bismarx-v1/IOTGW/IoTGW_Isolation/_dimensions/IoTGW_Isolation_3D.step

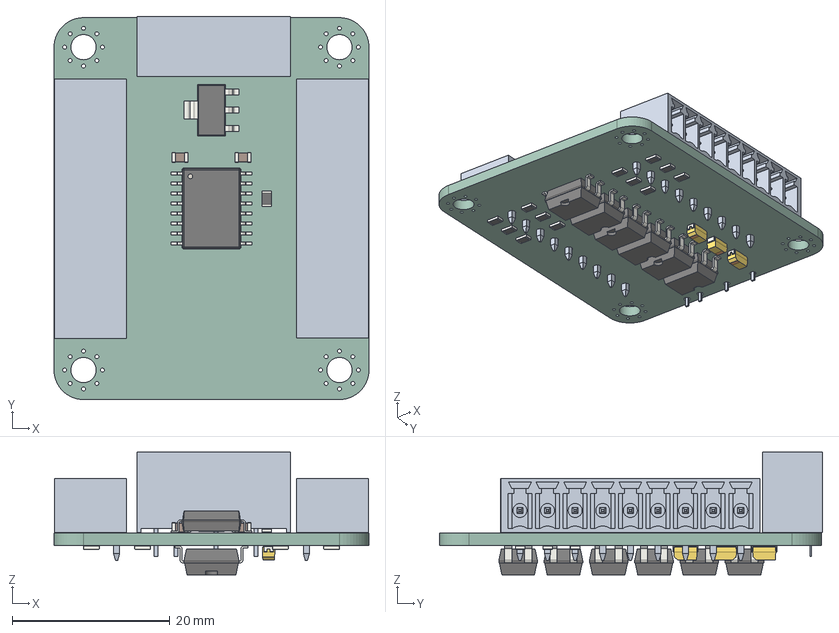
[picture p1: CAD file, 2025-01-31]
IoTGW_Isolation/_dimensions/IoTGW_Isolation_3D.step
40.0 x 48.7 x 15.6 mm
SOT_223
SOIC_16W_75x103mm_P127mm
R_0805_2012Metric x 13
C_0805_2012Metric x 2
TBA2-SINGLE
SMDIP_4_W953mm x 6
CP_EIA_3216_18_Kemet_A x 3
_autosave-IoTGW_Isolation_PCB
