bismarx-v1/IOTGW/IoTGW_Isolation/_dimensions/IoTGW_Isolation_schematic.pdf

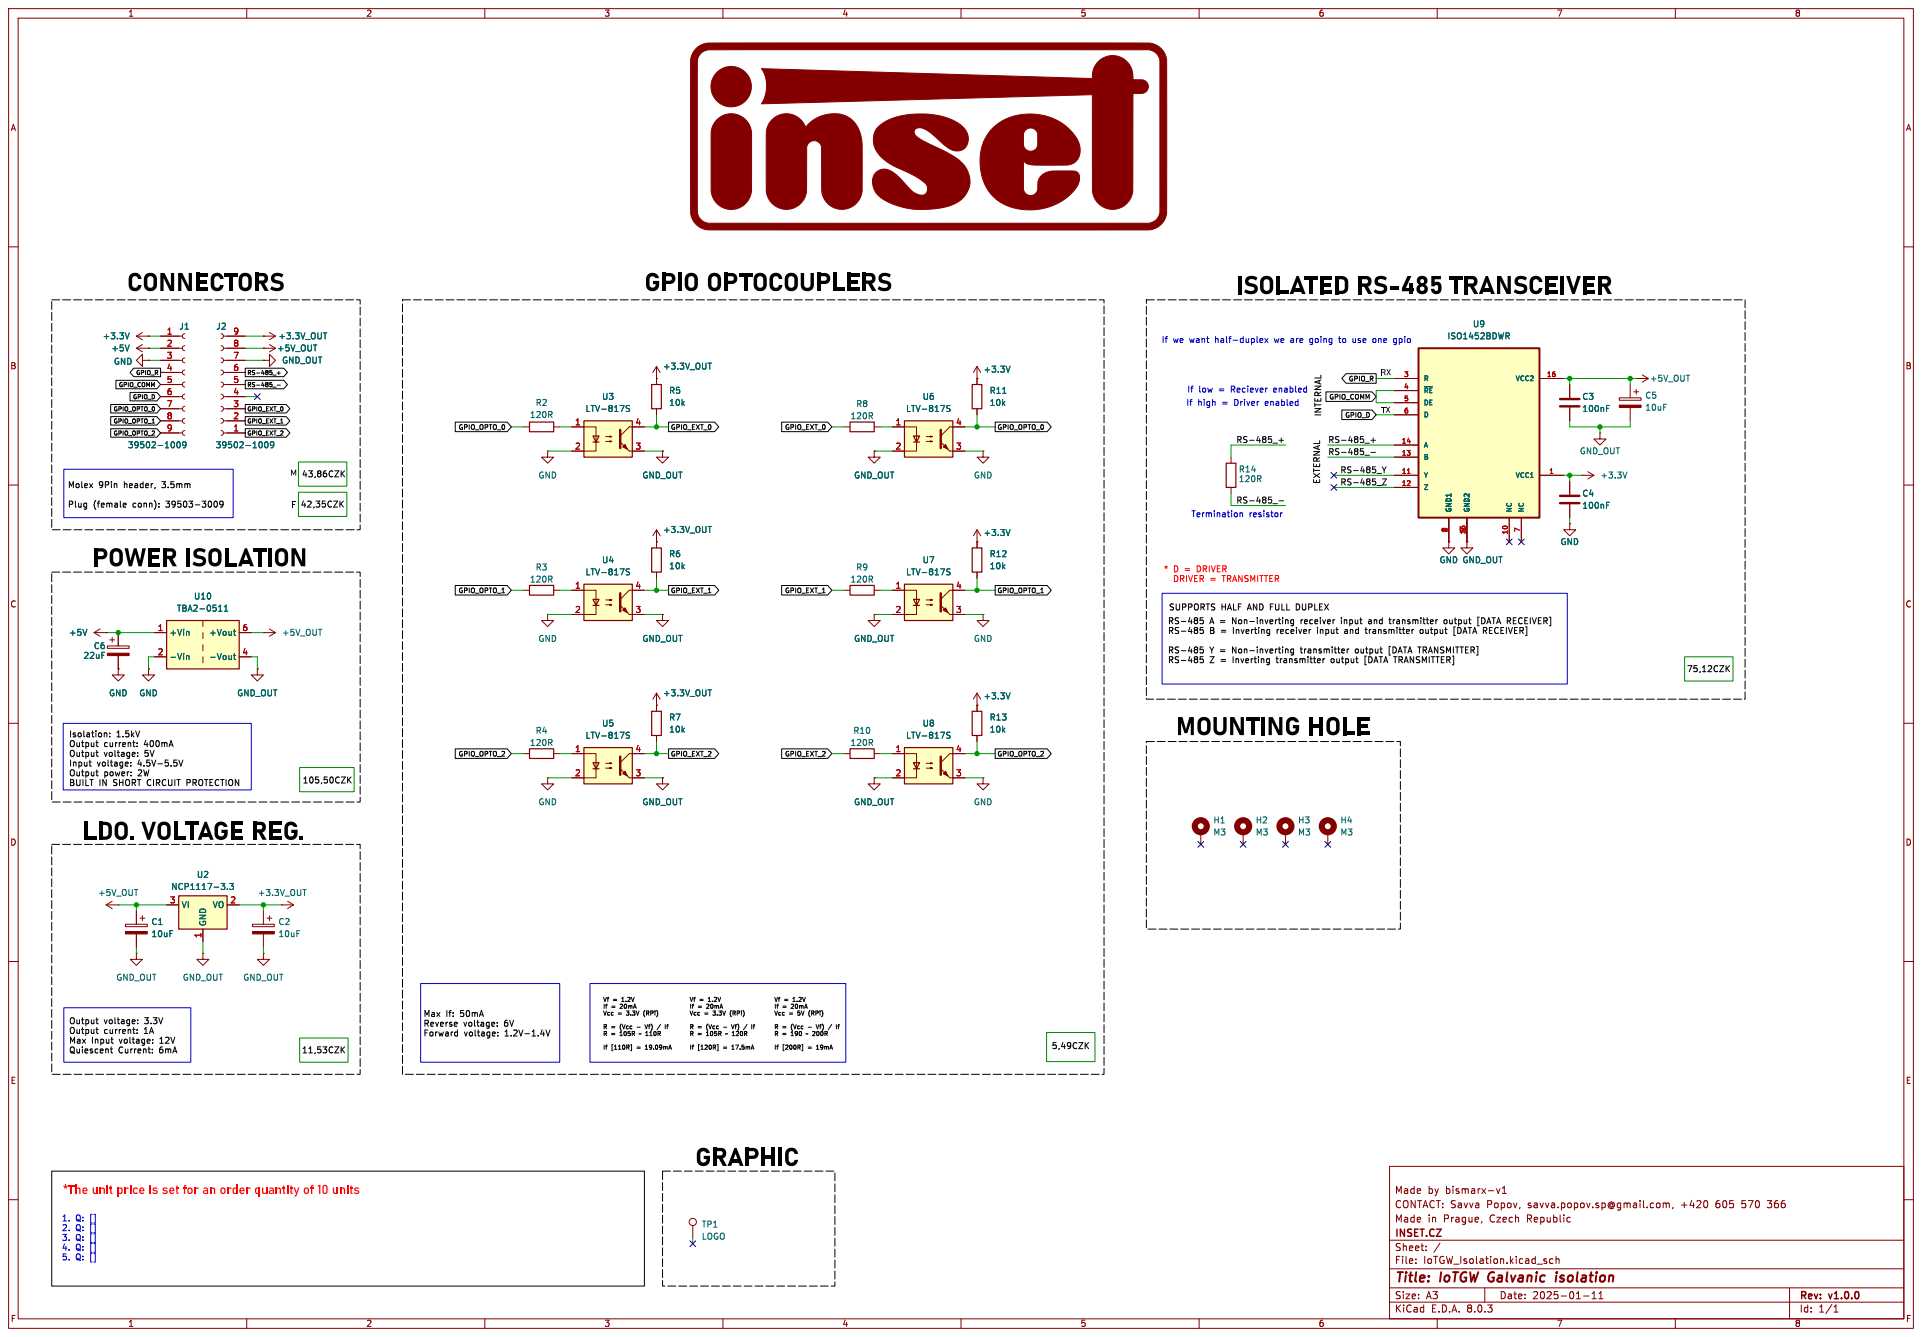
[picture p2: page 1]

Input voltage: 4.5V-5.5V Output power: 2W

Vcc = 3.3V (RPi) R = (Vcc - Vf) / If R = 105R ~ 110R

Vcc = 3.3V (RPi) R = (Vcc - Vf) / If R = 105R ~ 120R

Vcc = 5V (RPi) R = (Vcc - Vf) / If R = 190 ~ 200R

Max If: 50mA Reverse voltage: 6V

*The unit price is set for an order quantity of 10units

Id: 1/1 Title: IoTGW Galvanic isolation
