bismarx-v1/IOTGW/IoTGW_Isolation/_dimensions/IoTGW_Isolation_PCB_dimensions.pdf

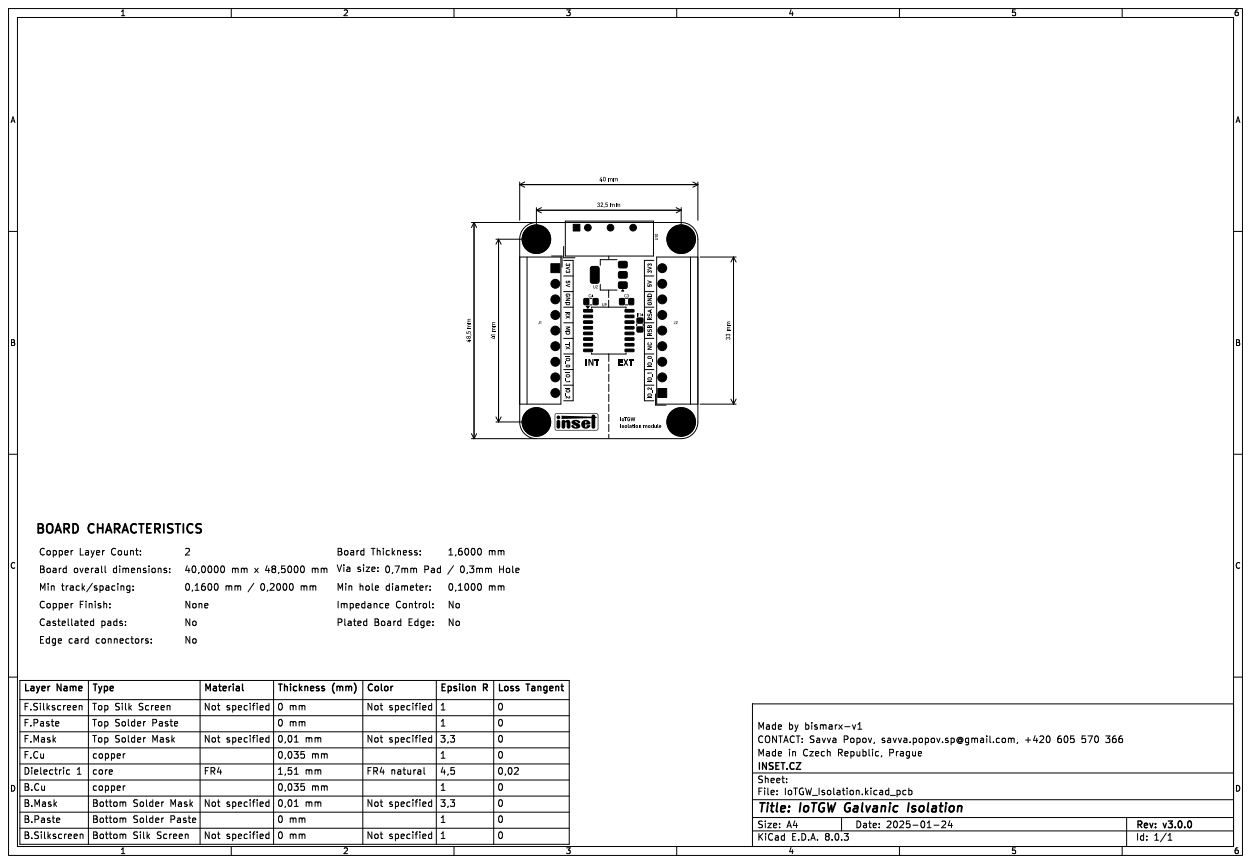
[picture p3: page 1]

Plated Board Edge:
Not specified Not specified FR4 natural Not specified

File: IoTGW_Isolation.kicad_pcb Sheet:
Id: 1/1 Title: IoTGW Galvanic Isolation
