bismarx-v1/IOTGW/IoTGW_Isolation/IoTGW_Isolation.kicad_pcb

## KiCad design IoTGW_Isolation/IoTGW_Isolation.kicad_pcb (2025-02-03)

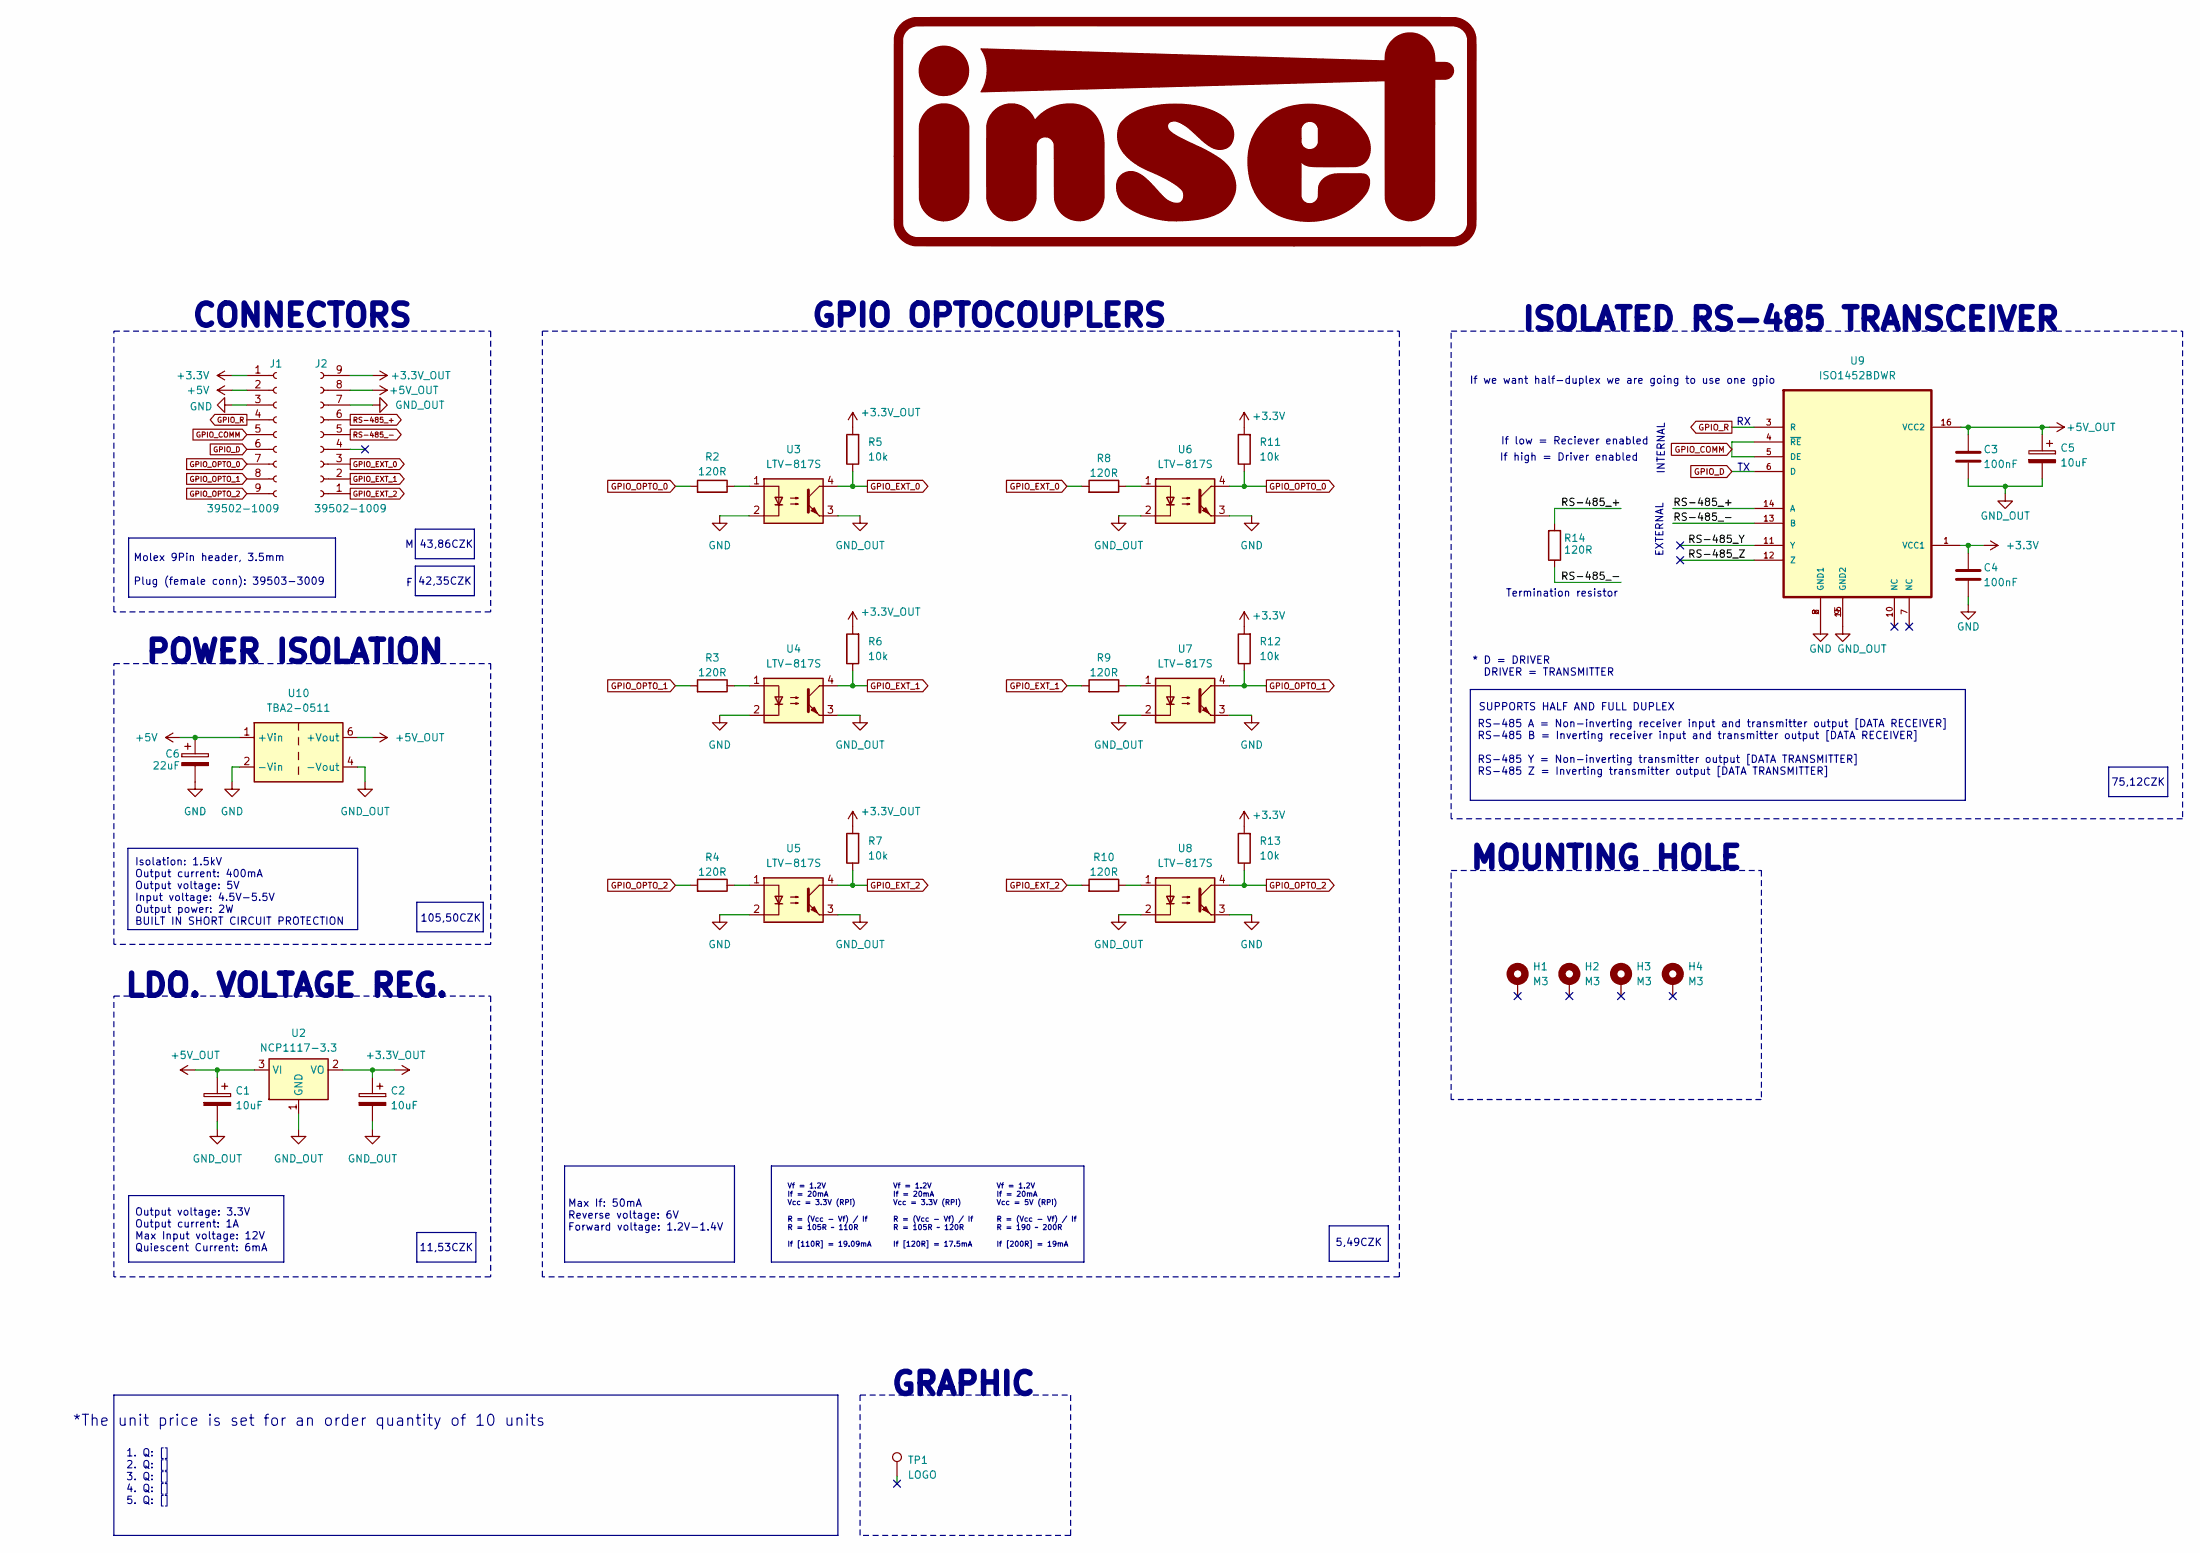
[picture p4: schematic IoTGW_Isolation.kicad_sch, IoTGW Galvanic isolation]

Parts:
C1, C2, C5: 10uF; CP_EIA-3216-18_Kemet-A_Pad1.58x1.35mm_HandSolder
C3, C4: 100nF; C_0805_2012Metric_Pad1.18x1.45mm_HandSolder
C6: 22uF; C_0805_2012Metric_Pad1.18x1.45mm_HandSolder
H1, H2, H3, H4: M3; MountingHole_3.2mm_M3_Pad_Via
J1, J2: 39502-1009; Molex_9pin_3.50
R2, R3, R4, R8, R9, R10, R14: 120R; R_0805_2012Metric_Pad1.20x1.40mm_HandSolder
R5, R6, R7, R11, R12, R13: 10k; R_0805_2012Metric_Pad1.20x1.40mm_HandSolder
TP1: LOGO; INSET_LOGO
U2: NCP1117-3.3; SOT-223-3_TabPin2
U3, U4, U5, U6, U7, U8: LTV-817S; SMDIP-4_W9.53mm
U9: ISO1452BDWR; SOIC-16W_7.5x10.3mm_P1.27mm
U10: TBA2-0511; Converter_DCDC_TRACO_TBA2-xxxx_Single_THT

Connections:
+3.3V: C4.1, J1.1, R11.2, R12.2, R13.2, U9.1 (VCC1)
+3.3V_OUT: C2.1, J2.9, R5.2, R6.2, R7.2, U2.2 (VO)
+5V: C6.1, J1.2, U10.1 (+Vin)
+5V_OUT: C1.1, C3.1, C5.1, J2.8, U2.3 (VI), U9.16 (VCC2), U10.6 (+Vout)
/RS-485_Y: U9.11 (Y)
/RS-485_Z: U9.12 (Z)
GND: C4.2, C6.2, J1.3, U3.2, U4.2, U5.2, U6.3, U7.3, U8.3, U9.2 (GND1), U9.8 (GND1), U10.2 (-Vin)
GND_OUT: C1.2, C2.2, C3.2, C5.2, J2.7, U2.1 (GND), U3.3, U4.3, U5.3, U6.2, U7.2, U8.2, U9.9 (GND2), U9.15 (GND2), U10.4 (-Vout)
GPIO_COMM: J1.5, U9.4 (~RE), U9.5 (DE)
GPIO_D: J1.6, U9.6 (D)
GPIO_EXT_0: J2.3, R5.1, R8.2, U3.4
GPIO_EXT_1: J2.2, R6.1, R9.2, U4.4
GPIO_EXT_2: J2.1, R7.1, R10.2, U5.4
GPIO_OPTO_0: J1.7, R2.2, R11.1, U6.4
GPIO_OPTO_1: J1.8, R3.2, R12.1, U7.4
GPIO_OPTO_2: J1.9, R4.2, R13.1, U8.4
GPIO_R: J1.4, U9.3 (R)
unnamed: R2.1, U3.1
unnamed: R3.1, U4.1
unnamed: R4.1, U5.1
unnamed: R8.1, U6.1
unnamed: R9.1, U7.1
unnamed: R10.1, U8.1
RS-485_+: J2.6, R14.2, U9.14 (A)
RS-485_-: J2.5, R14.1, U9.13 (B)

Notes on the sheet:
Vf = 1.2V If = 20mA Vcc = 5V (RPi) R = (Vcc - Vf) / If R = 190 ~ 200R If [200R] = 19mA
GRAPHIC
105,50CZK
42,35CZK
* D = DRIVER DRIVER = TRANSMITTER
If low = Reciever enabled
Molex 9Pin header, 3.5mm Plug (female conn): 39503-3009
Termination resistor
MOUNTING HOLE
If we want half-duplex we are going to use one gpio
ISOLATED RS-485 TRANSCEIVER
POWER ISOLATION
5,49CZK
GPIO OPTOCOUPLERS
1. Q: [] 2. Q: [] 3. Q: [] 4. Q: [] 5. Q: []
EXTERNAL
LDO. VOLTAGE REG.
Isolation: 1.5kV Output current: 400mA Output voltage: 5V Input voltage: 4.5V-5.5V Output power: 2W BUILT IN SHORT CIRCUIT PROTECTION
75,12CZK
INTERNAL
*The unit price is set for an order quantity of 10 units
CONNECTORS
Vf = 1.2V If = 20mA Vcc = 3.3V (RPi) R = (Vcc - Vf) / If R = 105R ~ 110R If [110R] = 19.09mA
11,53CZK
Output voltage: 3.3V Output current: 1A Max Input voltage: 12V Quiescent Current: 6mA
SUPPORTS HALF AND FULL DUPLEX
Max If: 50mA Reverse voltage: 6V Forward voltage: 1.2V-1.4V
RS-485 A = Non-inverting receiver input and transmitter output [DATA RECEIVER] RS-485 B = Inverting receiver input and transmitter output [DATA RECEIVER] RS-485 Y = Non-inverting transmitter output [DATA TRANSMITTER] RS-485 Z = Inverting transmitter output [DATA TRANSMITTER]
43,86CZK
Vf = 1.2V If = 20mA Vcc = 3.3V (RPi) R = (Vcc - Vf) / If R = 105R ~ 120R If [120R] = 17.5mA
If high = Driver enabled

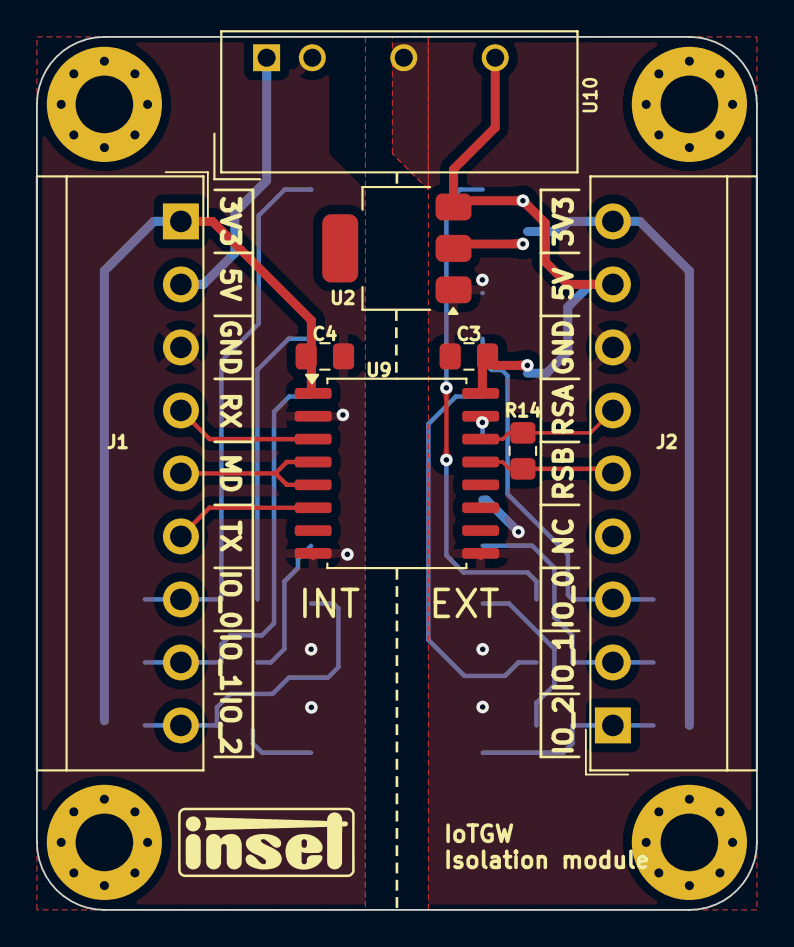
[picture p5: board IoTGW_Isolation.kicad_pcb from above]

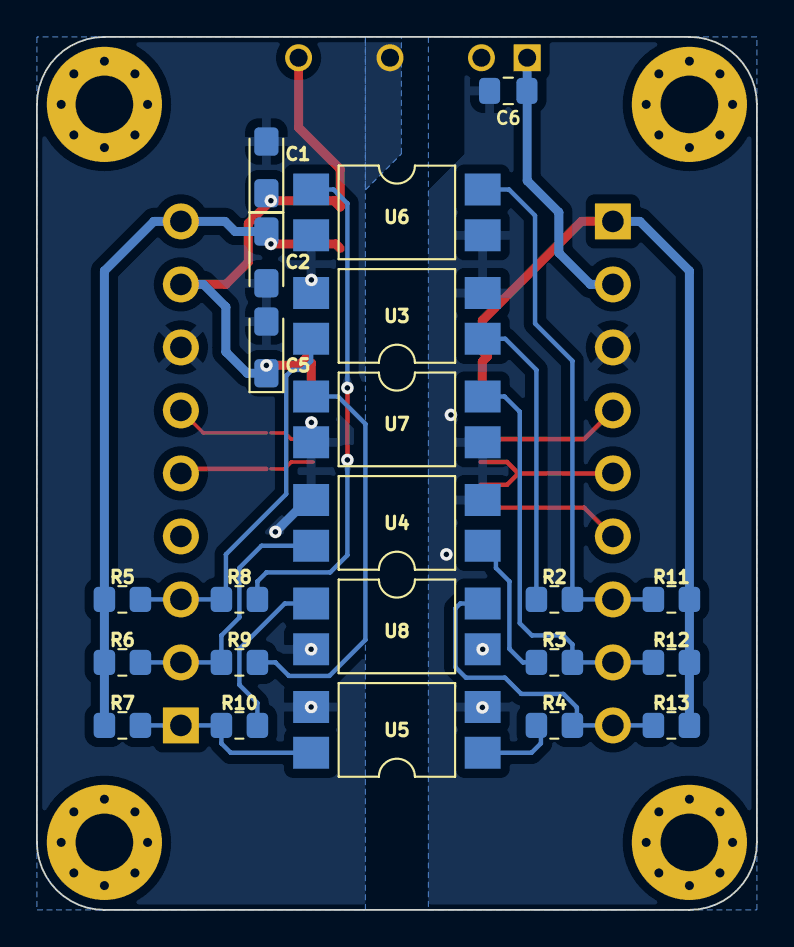
[picture p6: board IoTGW_Isolation.kicad_pcb from below]

Board: 2 copper layers, 40.0 x 48.5 mm, 35 parts (22 on the bottom side), 23 nets.
