bismarx-v1/IOTGW/(commit log)

2025-01-11 alot of stuff
    [IoTGW_Isolation.kicad_pcb, IoTGW_Isolation.kicad_sch, OptoCouplers.kicad_pcb, OptoCouplers.kicad_sch]
2025-01-12 reverse pol prot
    [IoTGW_Isolation.kicad_sch]
2025-01-13 updated schematic - comp cost
    [IoTGW_Isolation.kicad_sch]
2025-01-15 schematic upd
    [IoTGW_Isolation.kicad_sch]
2025-01-16 Schematic update
    [IoTGW_Isolation.kicad_sch]
2025-01-17 footprints + pcb
    [IoTGW_Isolation.kicad_pcb, IoTGW_Isolation.kicad_sch]
2025-01-18 PCB update, connectors 8pin
    [IoTGW_Isolation.kicad_pcb, IoTGW_Isolation.kicad_sch]
2025-01-20 PCB update
    [IoTGW_Isolation.kicad_pcb, IoTGW_Isolation.kicad_sch]
2025-01-23 PCB routing update
    [IoTGW_Isolation.kicad_pcb, IoTGW_Isolation.kicad_sch]
2025-01-23 pcb updates schemartic update
    [IoTGW_Isolation.kicad_pcb, IoTGW_Isolation.kicad_sch]
2025-01-23 step file
    [IoTGW_Isolation.step]
2025-01-24 smaller PCB
    [IoTGW_Isolation.kicad_pcb, IoTGW_Isolation.kicad_sch, IoTGW_Isolation.step]
2025-01-27 to do list 3.3v logic update
    [IoTGW_Isolation.kicad_sch]
2025-01-29 creatin of bom
    [IoTGW_bom.xlsx]
2025-01-29 schematic update 3.3V logic
    [IoTGW_Isolation.kicad_pcb, IoTGW_Isolation.kicad_sch]
2025-01-30 3,3V logic update
    [IoTGW_Isolation.kicad_pcb, IoTGW_Isolation.kicad_sch]
2025-01-30 3v3 update
    [IoTGW_Isolation.kicad_pcb]
2025-01-30 bom update
    [IoTGW.xlsx, IoTGW_Isolation.kicad_pcb, IoTGW_Isolation.kicad_sch]
2025-01-31 FInal PCB, plot, dimensions, 3D step file
    [IoTGW.xlsx, IoTGW_Isolation.kicad_pcb, IoTGW_Isolation.kicad_sch, IoTGW_Isolation.step, IoTGW_Isolation.xlsx, IoTGW_Isolation_3D.step, IoTGW_bom.xlsx, IoTGW_mouser.xls]
2025-02-02 silskscreeen update
    [IoTGW_Isolation.kicad_pcb]
2025-02-03 last update, plot of IoTGW isolation
    [IoTGW_Isolation.kicad_pcb]
2025-02-03 PCB - ordered
    [IoTGW_Isolation.kicad_sch, IoTGW_Isolation.xlsx, IoTGW_mouser.xls]
